Hudi452/Merjenje-osvetljenosti-svetilnosti-v-Lux-/Vezalna shema.PNG

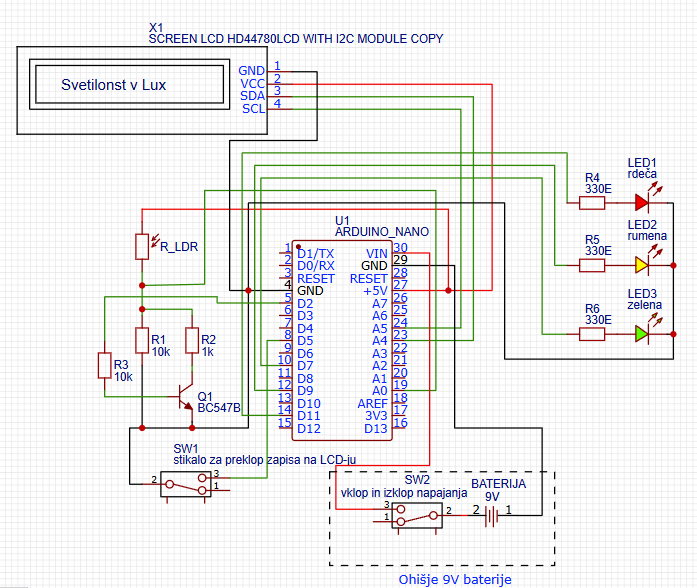
Vezalna shema.PNG
